mgstraface/robot-backend/cuerpos/pruebas/encastre_servo.stl

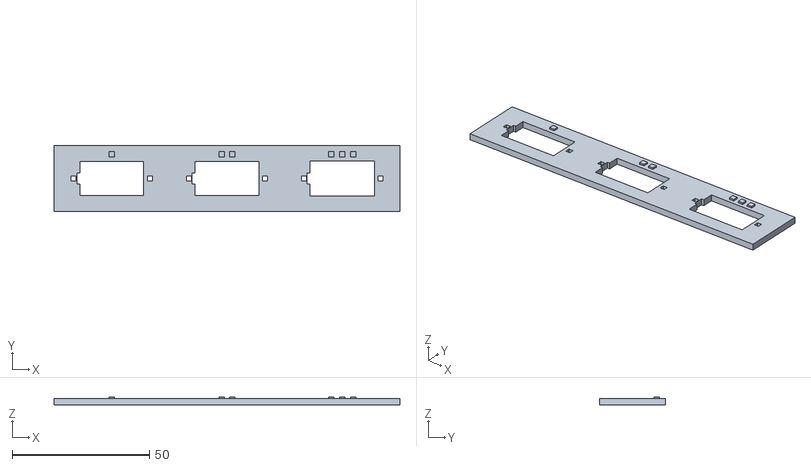
[picture p1: CAD file, 2026-11-04]
cuerpos/pruebas/encastre_servo.stl
126.0 x 24.0 x 3.00
