mgstraface/robot-backend/cuerpos/stl/robi_cuerpo_tapa.stl

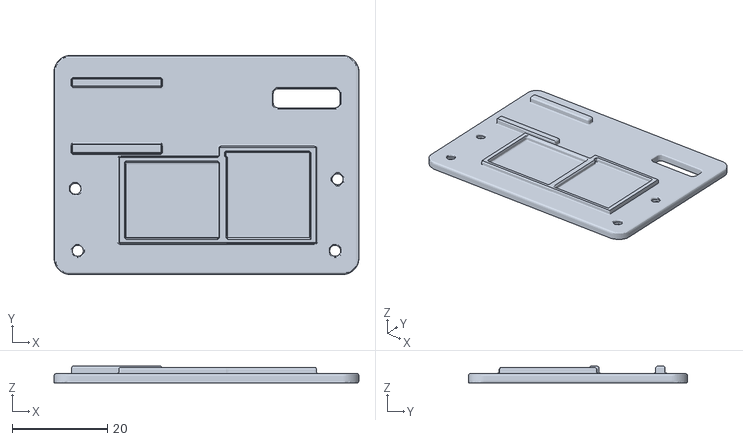
[picture p2: CAD file, 2026-11-05]
cuerpos/stl/robi_cuerpo_tapa.stl
64.0 x 46.0 x 3.50
