mgstraface/robot-backend/cuerpos/stl/v3/robi3_cuerpo_tapa.stl

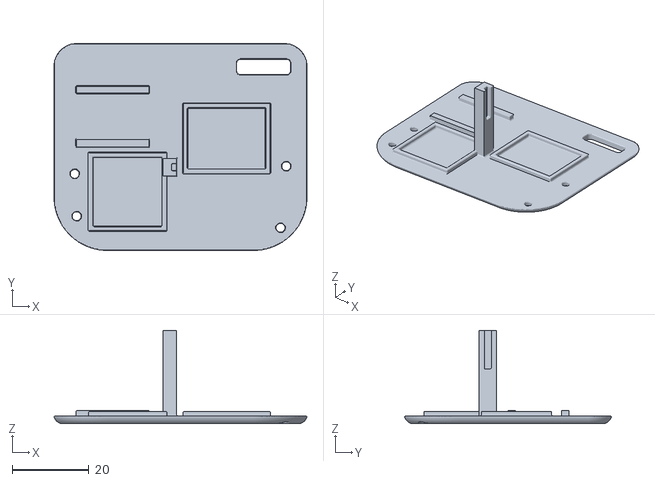
[picture p3: CAD file, 2026-11-05]
cuerpos/stl/v3/robi3_cuerpo_tapa.stl
65.8 x 53.8 x 24.3
