mgstraface/robot-backend/cuerpos/stl/robi_cabeza_tapa.stl

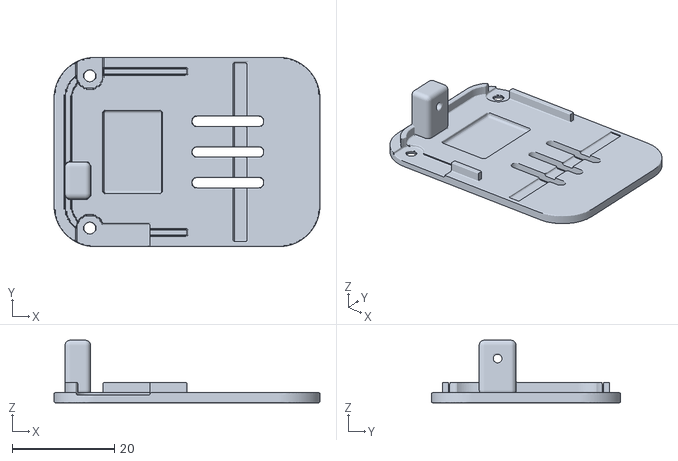
[picture p4: CAD file, 2026-11-05]
cuerpos/stl/robi_cabeza_tapa.stl
52.0 x 37.0 x 12.2
