mgstraface/robot-backend/cuerpos/stl/v3/robi3_cabeza_tapa.stl

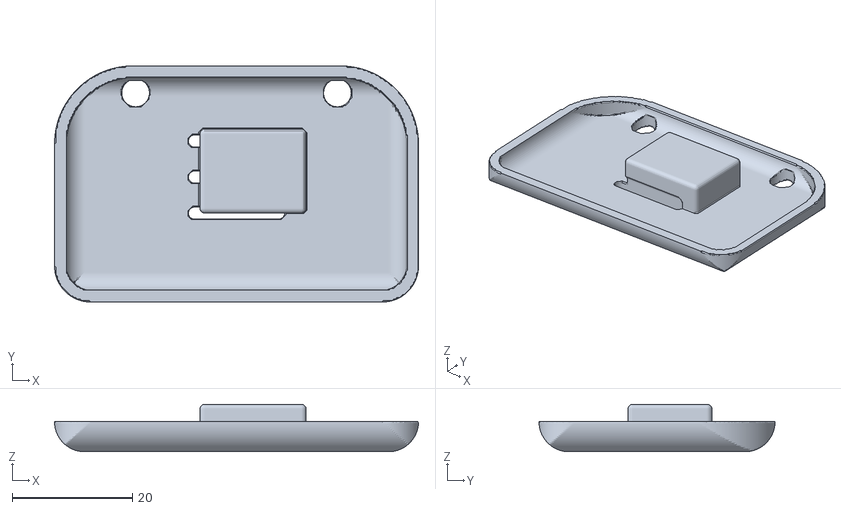
[picture p5: CAD file, 2026-11-05]
cuerpos/stl/v3/robi3_cabeza_tapa.stl
60.6 x 39.3 x 7.90
