mgstraface/robot-backend/cuerpos/stl/robi_cuerpo.stl

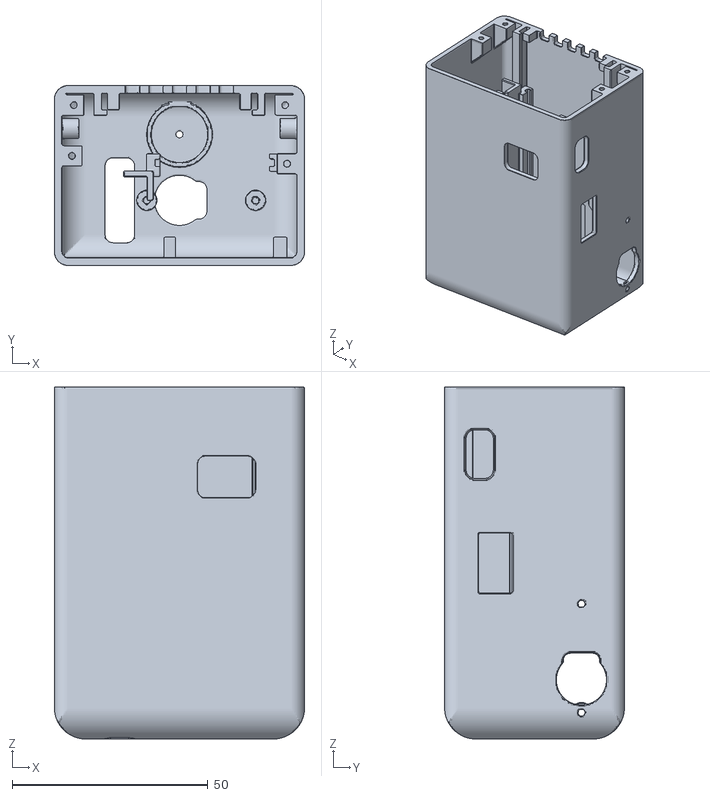
[picture p6: CAD file, 2026-11-05]
cuerpos/stl/robi_cuerpo.stl
64.0 x 46.0 x 90.0
