mgstraface/robot-backend/cuerpos/stl/v3/robi3_collar.stl

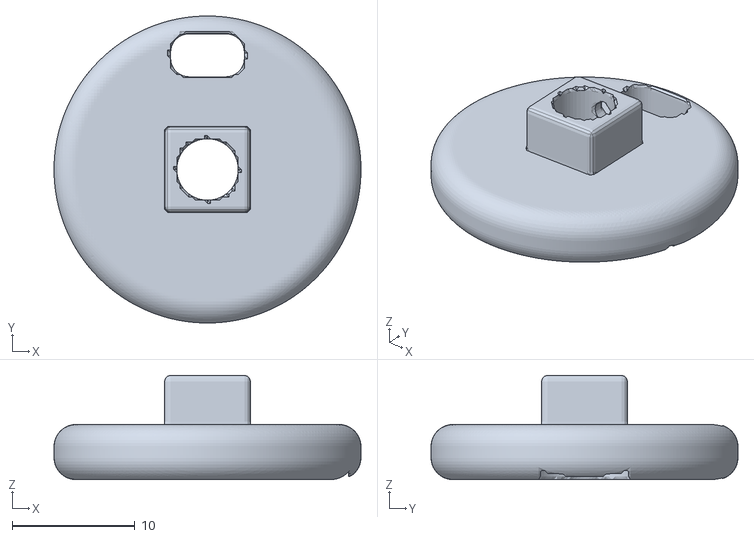
[picture p7: CAD file, 2026-11-05]
cuerpos/stl/v3/robi3_collar.stl
25.0 x 25.0 x 8.50
