mgstraface/robot-backend/cuerpos/stl/robi_brazo_der.stl

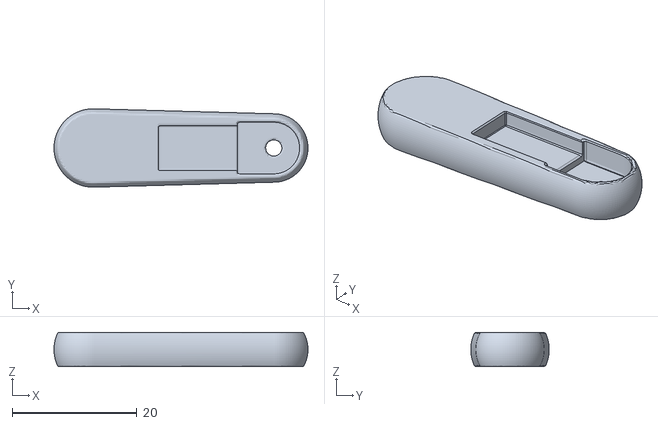
[picture p8: CAD file, 2026-11-05]
cuerpos/stl/robi_brazo_der.stl
40.8 x 12.6 x 5.50
