mgstraface/robot-backend/cuerpos/stl/v3/robi3_cabeza_frente.stl

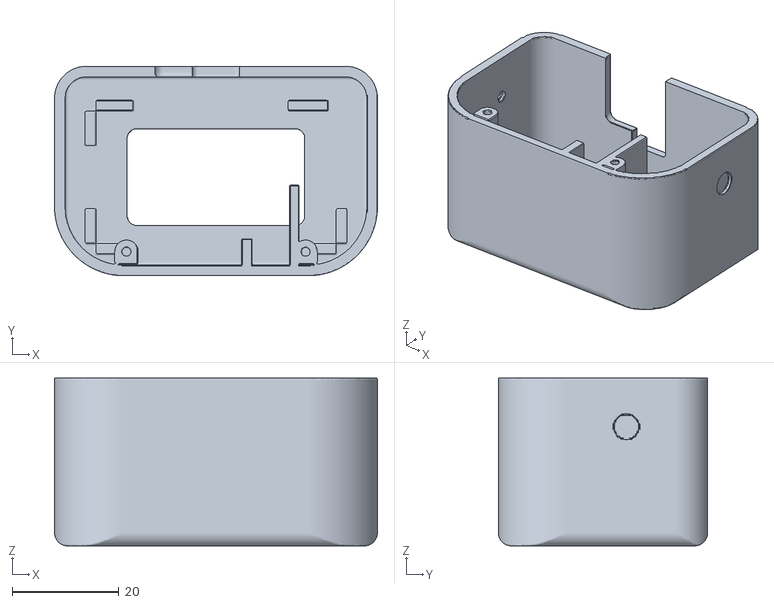
[picture p9: CAD file, 2026-11-05]
cuerpos/stl/v3/robi3_cabeza_frente.stl
60.6 x 39.3 x 31.5
