mgstraface/robot-backend/cuerpos/stl/robi_cabeza_frente.stl

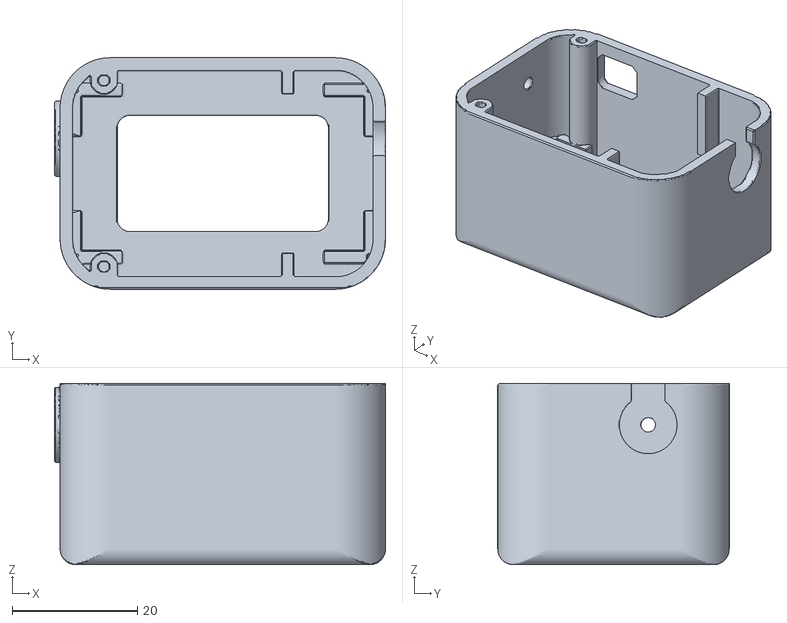
[picture p10: CAD file, 2026-11-05]
cuerpos/stl/robi_cabeza_frente.stl
52.9 x 37.0 x 29.0
