mgstraface/robot-backend/cuerpos/stl/v3/robi3_brazo_der.stl

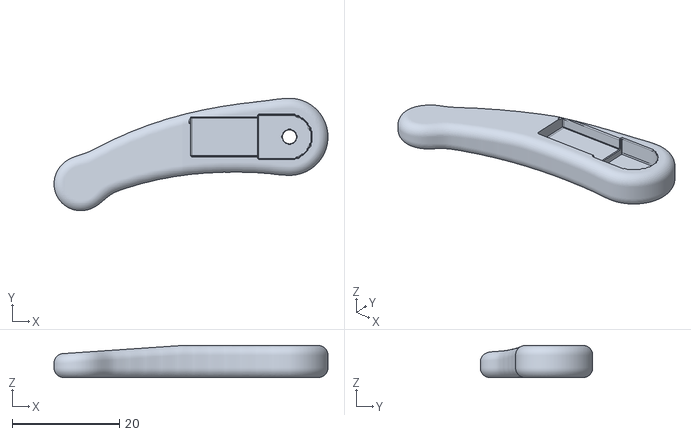
[picture p11: CAD file, 2026-11-05]
cuerpos/stl/v3/robi3_brazo_der.stl
51.2 x 21.0 x 6.00
