mgstraface/robot-backend/cuerpos/stl/robi_cuello_u.stl

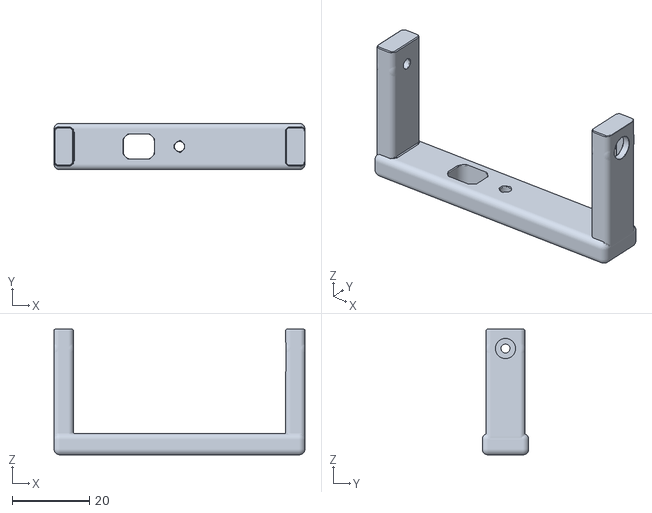
[picture p12: CAD file, 2026-11-04]
cuerpos/stl/robi_cuello_u.stl
64.8 x 12.0 x 32.5
