mgstraface/robot-backend/cuerpos/stl/v3/robi3_mecanismo.stl

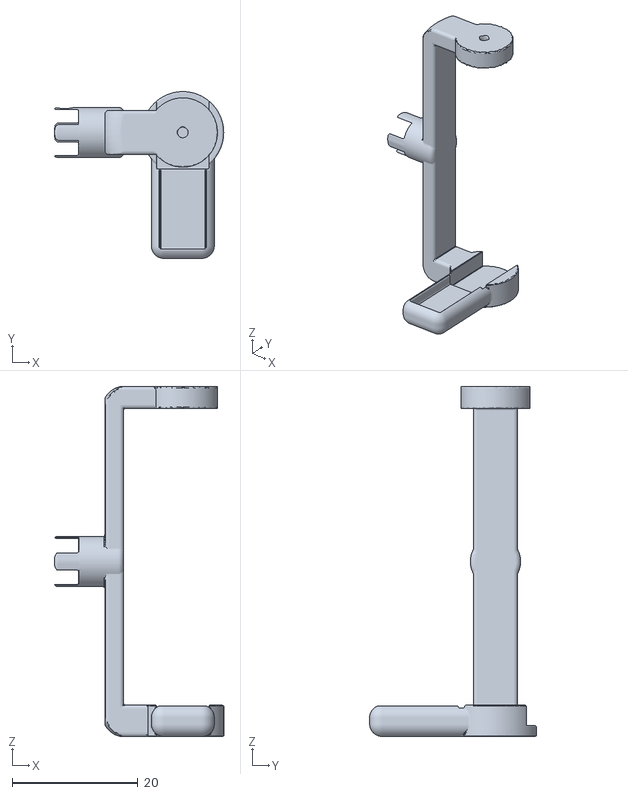
[picture p13: CAD file, 2026-11-05]
cuerpos/stl/v3/robi3_mecanismo.stl
26.9 x 26.5 x 55.6
