mgstraface/robot-backend/(list of files, cad)

Other CAD files:
cuerpos/stl/v3/robi3_cuerpo.stl
cuerpos/stl/robi_brazo_izq.stl
cuerpos/stl/v3/robi3_brazo_izq.stl
