mgstraface/robot-backend/cuerpos/pruebas/MEDIDAS.md

# Medidas tomadas con calibre (Mati, 3 nov 2026)

## Servo SG90 (Tower Pro)
- Largo con orejitas: 32,3 mm
- Largo del cuerpo: 22,9 mm (23,0 medido de abajo)
- Ancho del cuerpo: 12,0 mm
- Alto total con el eje: 31,7 mm
- Zona del engranaje (vista de arriba): 14,4 mm

## Bracito blanco de 2 puntas
- Largo total: 36,9 mm
- Diámetro del centro: 7,5 mm
- Espesor (parte plana): 1,9 mm

## Placa Waveshare ESP32-S3-Touch-LCD-1.47
- Espesor total, de la pantalla a la punta de los pines: 15,1 mm

## Parlante (módulo del S8+)
- Largo total 52,9 · parte ancha 38,7 · parte angosta 18,0 mm (falta espesor)

## Interruptor basculante mini (el chiquito, con patitas para soldar)
- Frente: 15,1 × 8,3 mm
- Profundidad total con las patitas: 17,0 mm

## Resultado de la pieza de prueba (A1 mini, PLA, 0.20 mm)
- Gana la holgura de 0,15 mm por lado (hueco •): entra justo, sin bailar.
- Agujeros piloto de 1,8 mm para los tornillitos del servo: OK.

## Medidas del 3-4 nov 2026
- Placa: largo 44,8 mm (marco 44,4; el USB-C asoma ~1 mm más de un lado). Ancho ≤ 24,85 (entraba en la v1 con 24,55 + holgura).
- Placa: 10,5 mm del frente de la pantalla al fondo (USB / separadores); 15,0 mm con los pines.
- Bracito de 1 punta: centro Ø 7,7 mm, largo total 21,6 mm (≈17,7 del centro a la punta), espesor 1,9.
- El cilindrito del bracito entra por el agujero de la pared (Ø 9,2) y agarra el eje del servo del SÍ: el ancho de la U está bien.

## Medidas del 5 nov 2026 (cuerpo)
- Portapila 18650 con la pila: largo 76,1 · ancho 21,0 · alto 19,9 mm. Cables salen por las dos puntas (rojo y negro).
- Módulo de carga X7 (placa violeta V2138, con display de %, USB-C de entrada, USB-A de salida atrás, botón S1 al costado):
  - Espesor total con el USB-A de atrás: 12,2 mm
  - Ancho 28,4 mm · largo total 34,5 mm (con el USB-C que sobresale)
  - Del comienzo del USB-C al botón S1: 19,1 mm
- Cable DuPont: Ø 1,2 mm (14–16 entran en el agujero de la U).
- Micrófono INMP441 (placa redonda, 6 agujeros): Ø 14,1 mm · espesor 1,9 mm (sin pines).
- Decidido: ventanita en la espalda para ver el display de % del X7 (USB-C y botón S1 al lado).
- Touch TTP223 (placa roja): 15,2 × 10,7 mm · espesor 2,1 mm (sin pines). Pines (3) en la punta corta.
- MPU6050 (GY-521, azul): 20,0 × 15,6 mm · alto 2,7 mm con componentes (sin pines). 2 agujeros de tornillo en las esquinas del lado opuesto a los pines.
- Placa perforada: 40 × 60 mm · espesor 1,5 mm · 14 × 20 agujeros (paso 2,54), doble faz con agujeros sueltos (sin tiras), 4 agujeros de montaje en las esquinas. Se va a cortar a medida.
- Amplificador MAX98357A (placa violeta): 17,7 × 17,7 mm · espesor 2,1 mm. Trae bornera verde aparte (7,0 × 6,7 × 12,1 con patitas): no se usa, el parlante va soldado directo.
- Capacitor 1000 µF: Ø 10,0 × 19,6 mm (sin patitas). Va acostado en la perfo.
- Diodos (cuerpo negro con patitas axiales): largo del cuerpo 5,0 mm. Modelo a confirmar (leer la inscripción).
- Parlante (módulo del S8+, en forma de L): espesor 4,0 mm · largo total 53,5 · ancho total 39,5 mm (medidas del 5/11; antes 52,9 y 38,7). El sonido sale por el canto: dos ranuritas en el borde corto de abajo de la caja (debajo de la chapa plateada).
