mgstraface/robot-backend/(commit log)

2026-10-28 Agrega script de deploy para el VPS
    Claude-Session: https://claude.ai/code/session_01FqtonhUX6X1YaRs8dVXFi7
2026-10-28 Deploy con Docker: compose con backend, Mongo y panel
    Reemplaza PM2 y nginx del host, que chocaban con los otros
    proyectos en contenedores del VPS.
    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
2026-10-28 Deploy en /root/robot, igual que los otros proyectos del VPS
    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
2026-10-28 Endpoint /api/tts para escuchar la voz del servidor en la PC
    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
2026-10-28 Mongo del robot accesible por túnel SSH para desarrollo local
    Publica el puerto solo en 127.0.0.1 del VPS (27020), sin exponerlo
    a internet.
    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
2026-10-28 Deploy automático al VPS en cada push a main
    GitHub Actions entra por SSH y corre scripts/deploy-vps.sh. El script
    toma un lock para que dos deploys no se pisen.
    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
2026-10-28 Apariencia: color de facciones y estilo de cara (tierno/terror)
    Se guardan con la personalidad, se validan en la API y se mandan a los
    robots conectados al instante (mensaje "appearance"). Corrige además el
    upsert de la personalidad, que chocaba si el documento no existía.
    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
2026-10-28 Entorno de pruebas en dev.robot.malestraface.com
    El script de deploy maneja prod (main) y dev (rama dev) con carpetas,
    contenedores, puertos y base de datos separados. Para dev arma el .env a
    partir del de producción, crea el sitio de nginx y pide el certificado.
    Los tokens ya no se imprimen en los logs de GitHub Actions.
    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
2026-10-28 Redeploy para subir los cambios del panel
    El workflow de robot-frontend todavía no tiene los secrets; el deploy
    de este repo actualiza los dos.
    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
2026-10-28 Rutinas: saludo, reuniones, agua, susto, foco y deploys
    Reloj que una vez por minuto saluda al despertarse (hora, clima de
    Open-Meteo y agenda), avisa reuniones leyendo el iCal del usuario (con
    repeticiones y excepciones), recuerda tomar agua, cierra el bloque de
    foco y reparte sustos. Los avisos llegan al robot por WebSocket y al
    panel por /api/feed. Suma reacciones al sensor de movimiento y el aviso
    del resultado de cada deploy.
    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
2026-10-28 Fotos del portarretrato y prueba de rutinas
    API de fotos (JPEG ya achicado, hasta 60) que también puede leer el
    robot con su token y aviso "photos" para que sincronice su SD; ajustes
    del portarretrato; POST /api/try/:kind para disparar cada rutina.
    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
2026-10-28 Redeploy para subir el arreglo del micrófono del panel
    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
2026-10-29 Movimientos de cabeza: gestos, posturas por emoción y juego Sí o no
    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
2026-10-29 Comandos sin IA (hora, clima, timers, alarmas, chistes, foco) y pestañas del panel que no se cortan
    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
2026-10-29 Voz gratis opcional: Whisper + Piper en el VPS (servicio "voz")
    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
2026-10-29 Bocas, caras nuevas (asustado, pícaro, aburrido, riendo), boca que habla y gestos nuevos de vida propia
    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
2026-10-29 Newell's: partidos en vivo, festejo de goles, chicana a Central y personalidad leprosa
    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
2026-10-29 Anotador de truco con fósforos y pruebas de fútbol (gol de Central, victoria, derrota, perdió Central)
    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
2026-10-29 Frases y cantitos leprosos cada tanto, editables desde el panel
    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
2026-10-29 La voz ya no deletrea el GOL ni lee mal las risas; noticias de Newell's por comando
    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
2026-10-29 Voz gratis con acento argentino (voces de Microsoft Edge) y selector de voz y tono
    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
2026-10-29 Workflow manual para probar la voz de Edge
    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
2026-10-29 Probar voz: mostrar el resultado como anotación
    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
2026-10-29 Voz de Edge: token Sec-MS-GEC v2 (Microsoft lo cambió y daba 403)
    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
2026-10-29 Voz de Edge en MP3 (el formato que acepta el servicio)
    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
2026-10-29 Modo Halloween automático el 31 y cotización del dólar por voz
    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
2026-10-29 Movimientos de brazos (saludar, festejar, aplaudir, no sé, taparse, abrazo, bailar, señalar) y Huesito de cuerpo entero en el panel
    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
2026-10-30 Firmware etapa 1: pantalla, WiFi y conexión con el servidor (PlatformIO)
    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
2026-10-30 Ánimo, memoria de largo plazo, cumpleaños, cuento de terror, calibración de servos y diagnóstico
    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
2026-10-30 Asistente de cocina (recetas en formato Robi o con IA, paso a paso con timers), temporizador y cronómetro
    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
2026-10-30 Cocina: cabeza = siguiente paso, panza = anterior; la cara aparece mientras habla; texto más chico en pantalla
    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
2026-10-30 Firmware: varias redes WiFi (se conecta sola a la que encuentre)
    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
2026-10-30 Firmware: corrige choque de nombres de colores con la librería; compilación automática en GitHub
    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
    [face.cpp]
2026-10-30 Firmware: si no encuentra el WiFi, lista las redes que ve
    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
2026-10-30 Panel: mostrar el token del robot en la pestaña Robot para copiarlo al firmware
    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
2026-10-30 Firmware: pines verificados con el esquema (RST de pantalla en 40) y arranque del JD9853
    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
2026-10-30 Firmware: registra en el monitor cada mensaje del servidor
    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
2026-10-30 Firmware: la cara volvía a neutral al instante (resta de tiempos sin signo)
    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
2026-10-30 Robot: pantalla táctil, gestos y menú en la placa (cocina, temporizador, cronómetro, pomodoro, clima, chiste, modo, brillo, vistazo)
    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
2026-10-30 Robot: cancelar el timer antes de tiempo (mantener apretado o desde el menú)
    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
2026-10-30 Firmware: reproduce las caras y animaciones del panel (caras.bin), vida propia y particiones de 7 MB
    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
    [particiones.csv]
2026-10-30 La placa mueve la boca mientras suena la voz en el celu/PC (el panel le avisa)
    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
2026-10-30 Actualización de la placa por WiFi: GitHub publica el firmware, el servidor se lo ofrece y la placa se actualiza sola
    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
2026-11-03 Firmware: modo configuración del WiFi desde el celu (red Robi-config) y opción en el menú
    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
2026-11-03 Firmware: salir del modo configuración manteniendo apretada la pantalla
    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
2026-11-03 Firmware: servos (calibración desde el panel, gestos de cabeza y brazos, STOP)
    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
2026-11-03 Firmware: los gestos de servos van a la velocidad necesaria para completar cada movimiento
    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
2026-11-03 Firmware: los gestos se salteaban todos los movimientos (resta de tiempos sin signo)
    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
2026-11-03 Pantalla girada 180° (opción en la pestaña Robot): da vuelta imagen y táctil
    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
2026-11-03 Buscar actualización siempre consulta la última versión publicada
    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
2026-11-03 Firmware: pantalla girada 180° por software (el JD9853 no aplicaba el giro por hardware)
    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
2026-11-03 Firmware: nota sobre el servo del SÍ (no se suelta en Robi v2)
    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
2026-11-04 Gestos de cabeza en diagonal: arriba/abajo + izquierda/derecha
    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
2026-11-04 Piezas 3D de Robi (v1.2) en cuerpos/: código, STL y medidas
    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
    [encastre_servo.stl, robi_cabeza_frente.stl, robi_cabeza_tapa.stl, robi_cuello_u.stl]
2026-11-04 Cabeza v1.2.1: saca la lámina de 0,15 mm que cruzaba la ranura del nervio del servo
    La ranura que deja pasar la placa empezaba en SERVO_Y0 + holgura y dejaba una
    capa finita cruzando de lado a lado. Ahora arranca 1 mm antes del nervio.
    Claude-Session: https://claude.ai/code/session_01FqtonhTSrrVaLVZYZmxRaD
    [robi_cabeza_frente.stl]
2026-11-04 Cuello U v1.3: muesca del centro del bracito a 3 mm de hondo
    El centro redondo del bracito de 1 punta mide 3,0 mm (no 1,9 como el brazo).
    La muesca del centro ahora tiene 3,25 mm (con holgura) en los dos lados (SÍ y NO);
    el brazo de la U pasa de 4 a 5 mm y la base de 4,5 a 5,5 mm para no quedar finitos.
    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
    [robi_cuello_u.stl]
2026-11-04 Cuello U v1.3: la zona honda de la muesca también cubre la rampita del bracito
    Del lado que entra en la muesca, el centro del bracito tiene una rampita hacia el
    brazo (9,0 mm desde el borde del círculo de 7,2). La zona de 3,25 mm de hondo ahora
    llega hasta 5,8 mm del centro, en los dos lados (SÍ y NO).
    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
    [robi_cuello_u.stl]
2026-11-05 Cabeza v1.2.2: sin orejita del lado del servo
    La orejita redonda del lado del servo no dejaba que la U se arrimara y el bracito
    agarraba apenas la puntita del eje del SÍ. Queda solo la del lado de la bisagra.
    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
    [robi_cabeza_frente.stl]
2026-11-05 Medidas del micrófono y ventanita de batería
    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
2026-11-05 Medidas de la placa perforada
    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
2026-11-05 Medidas del capacitor y los diodos
    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
2026-11-05 Cuerpo v1 de Robi (carcasa, tapa de abajo, brazos) + tapa de la cabeza v1.3
    - robi2_cuerpo.py: carcasa de 64 × 46 × 92 mm con todo adentro (servos, pila, parlante,
    X7 con ventanita, perfo, interruptor, mic, touch, MPU y ampli), chequeado contra choques.
    Se imprime boca abajo y sin soportes (salientes con chaflán a 45°).
    - robi2_cuerpo_generar.py y robi2_cuerpo_render.py.
    - Tapa de la cabeza v1.3: pared de 1 mm para el touch de la nuca.
    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
    [robi_brazo_der.stl, robi_brazo_izq.stl, robi_cabeza_tapa.stl, robi_cuerpo.stl, robi_cuerpo_tapa.stl]
2026-11-05 Bocetos de silueta redondeada para el cuerpo (poroto y mini)
    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
2026-11-05 Bocetos: brazos curvos y opción de cuello escondido (sin U)
    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
2026-11-05 Cabeza v3 con cuello escondido (en progreso, sin STL todavía)
    robi3.py: cabeza redondeada 60,6 × 36,5 × 39,3, servo del SÍ adentro, mecanismo interno
    (brazos + barra + cuello) y collar en el servo del NO. Verificado sin choques en ±18°.
    Falta: cuerpo poroto, brazos curvos, STL y renders.
    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
2026-11-05 Robi v3: cuerpo poroto, brazos curvos, STL de todo; ARRIBA/ABAJO a ±18°
    - robi3_cuerpo.py: carcasa poroto 66×54×94 (59,4 arriba) con todo adentro + chequeo de huelgos,
    tapa de abajo y brazos curvos que se afinan con la muesca escalonada del bracito
    - collar: agujero de cables atrás (sobre la medialuna del techo; a la izquierda caía sobre el pilar del NO)
    - robi3_generar.py / robi3_render.py: 8 STL en stl/v3 y render final
    - firmware: gestos mirarArriba/mirarAbajo limitados a ±18°
    [robi3_brazo_der.stl, robi3_brazo_izq.stl, robi3_cabeza_frente.stl, robi3_cabeza_tapa.stl, robi3_collar.stl, robi3_cuerpo.stl, robi3_cuerpo_tapa.stl, robi3_mecanismo.stl]
2026-11-05 robi3: arreglar techo del cuerpo (interior hasta ZI_TOP), guía de la pila unida al techo y brazos con cúpula
    - interior(): el techo por dentro terminaba en Z_TOP y quedaba con 0 mm de espesor;
    todo lo que cuelga del techo (mic, pilares del servo del NO, guía de la pila) flotaba.
    - guía en L de la pila: costilla vertical hasta el techo (el apoyo anterior no llegaba).
    - BR_TOP -43,7 -> -45,2: con el techo bien los servos de los brazos se metían 0,19 mm en la pared.
    - brazos: paleta con cara de adentro plana y cúpula afuera; se imprimen con la cara plana en la cama.
    - robi3_flota.py: cuenta las piezas sueltas (componentes conectados) de la malla del cuerpo.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
    [robi3_cuerpo.py, robi3_flota.py, robi3_generar.py]
